cmu-argus-2/Avionics-Plus-Z/+Z.step

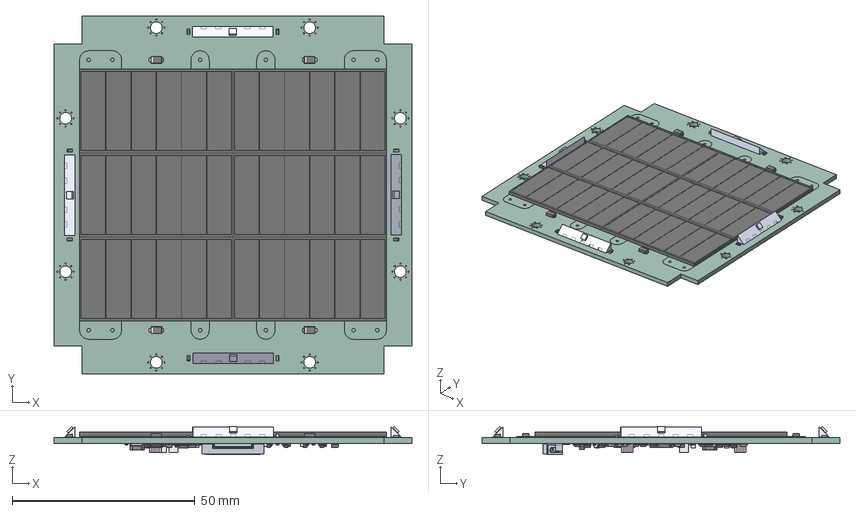
[picture p1: CAD file, 2026-02-09]
+Z.step
98.0 x 98.0 x 7.70 mm
D_PowerDI-123 x 6
R_0603_1608Metric x 117
SS_Base x 4
BODY-SON.stp x 4
FRAME-DNP0006A.stp x 4
DIE.stp x 4
BOND_WIRE_AF0.stp x 4
BOND_WIRE_AF1.stp x 4
BOND_WIRE_AF2.stp x 4
BOND_WIRE_AF3.stp x 4
BOND_WIRE_AF4.stp x 4
BOND_WIRE_AF5.stp x 4
C_0603_1608Metric x 26
SM141K06TF x 6
Cell Backer_PCB
SOT-363_SC-70-6 x 24
C_1210_3225Metric x 4
Fuse_0603_1608Metric x 10
SOT-23-6
QFN-20-1EP_3x4mm_P0.5mm_EP1.65x2.65mm
D_SOD-123F
+Z 1.74.1
BODY-QFN
PIN1-ID
TSOT-23-6
C_0805_2012Metric x 3
Pins
SOT-23
LPS4018-103MRC
LED_0603_1608Metric
SIRA99DP-T1-GE3 x 2
MSOP-10_3x3mm_P0.5mm
R_2512_6332Metric
+Z_PCB
