cmu-argus-2/Avionics-Plus-Z/Cell Backer/Cell Backer.step

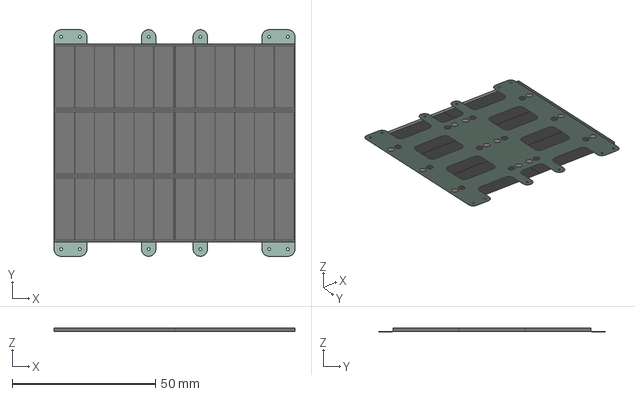
[picture p2: CAD file, 2026-02-09]
Cell Backer/Cell Backer.step
84.0 x 79.0 x 1.30 mm
SM141K06TF x 6
Cell Backer_PCB
