cmu-argus-2/Avionics-Plus-Z/LightSensorBreakout/LightSensorBreakout.step

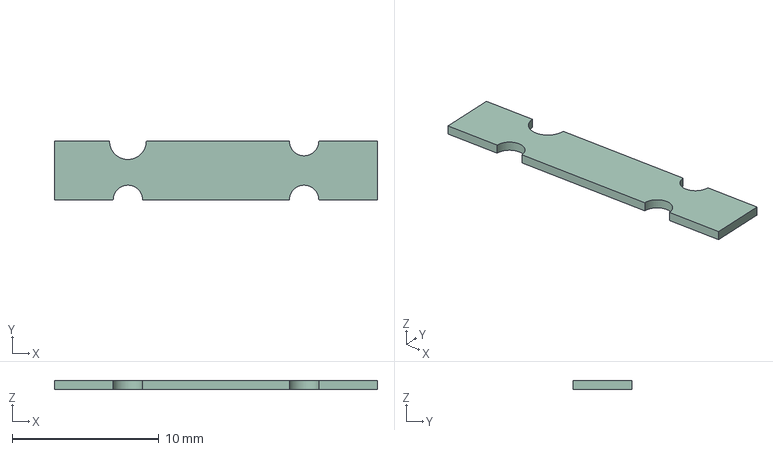
[picture p3: CAD file, 2026-01-21]
LightSensorBreakout/LightSensorBreakout.step
22.0 x 4.00 x 0.6 mm
