cmu-argus-2/Avionics-Plus-Z/+Z.kicad_pcb

## KiCad design +Z.kicad_pcb (2026-03-23)

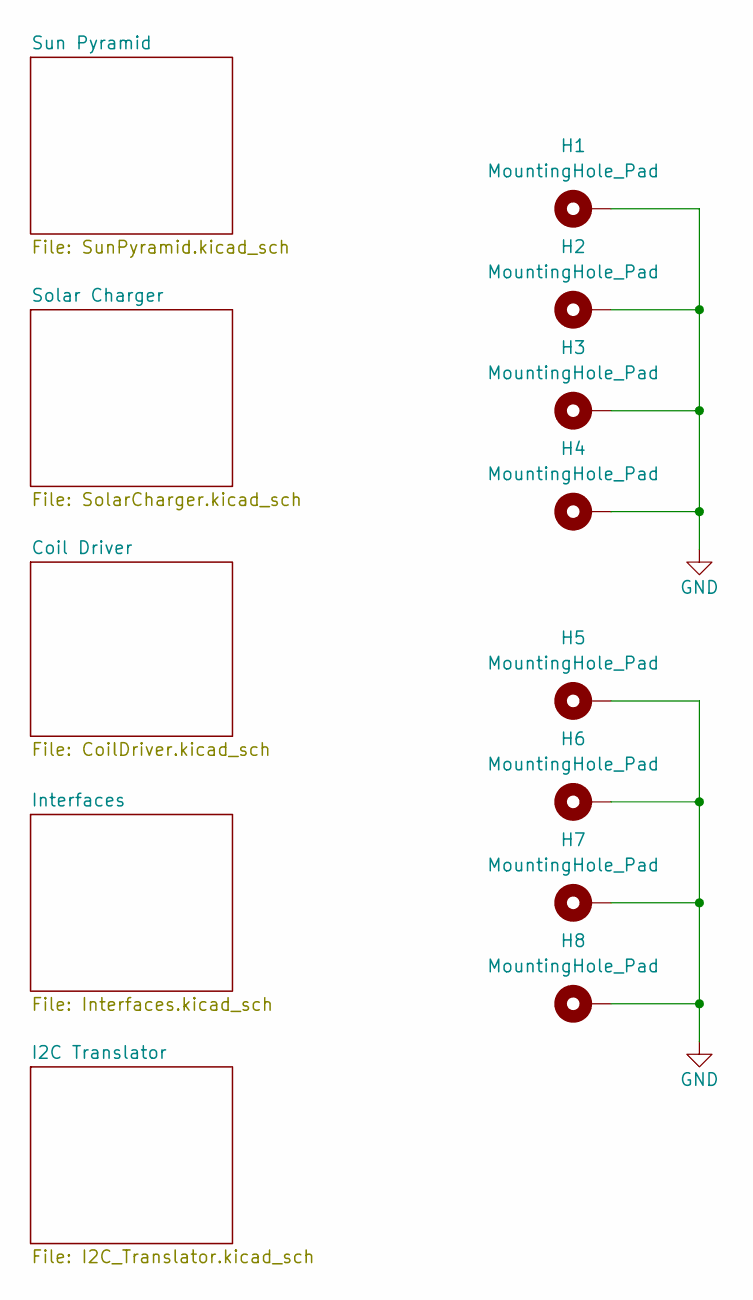
[picture p4: schematic +Z.kicad_sch, Argus +Z Solar Panel]

Parts:
H1, H2, H3, H4, H5, H6, H7, H8: MountingHole_Pad; MountingHole_3.2mm_M3_DIN965_Pad_TopBottom

Connections:
GND: H1.1, H2.1, H3.1, H4.1, H5.1, H6.1, H7.1, H8.1; also elsewhere on the board

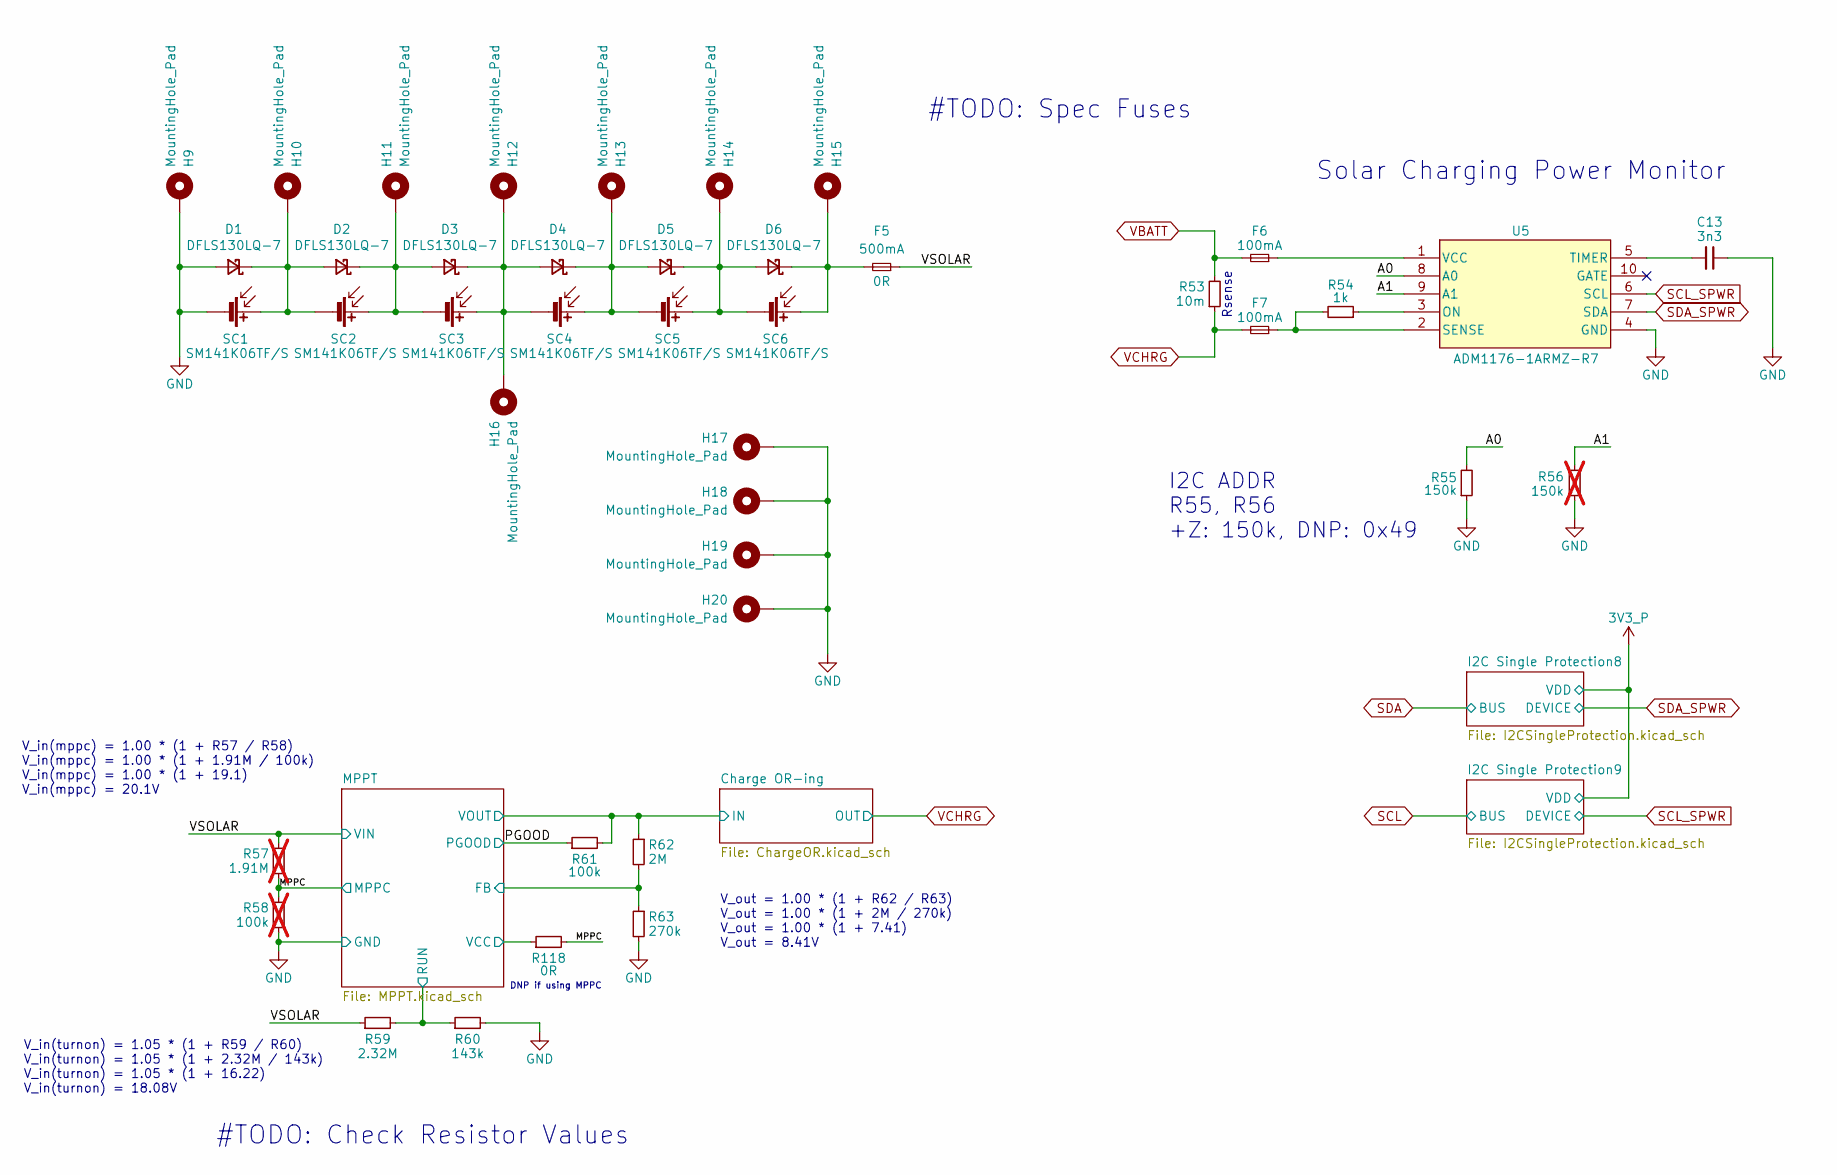
[picture p5: schematic SolarCharger.kicad_sch, Argus +Z Solar Panel]

Parts:
C13: 3n3; C_0603_1608Metric; MPN C3877267
D1, D2, D3, D4, D5, D6: DFLS130LQ-7; D_PowerDI-123
F5: 500mA; Fuse_0603_1608Metric
F6, F7: 100mA; Fuse_0603_1608Metric
H9, H10, H11, H12, H13, H14, H15, H16, H17, H18, H19, H20: MountingHole_Pad; TestPoint_Pad_D1.0mm
R53: 10m; R_2512_6332Metric; MPN C840621
R54: 1k; R_0603_1608Metric; MPN C2484712
R55: 150k; R_0603_1608Metric
R56: 150k; R_0603_1608Metric; MPN C402995; not fitted
R57: 1.91M; R_0603_1608Metric; not fitted
R58: 100k; R_0603_1608Metric; not fitted
R59: 2.32M; R_0603_1608Metric
R60: 143k; R_0603_1608Metric
R61: 100k; R_0603_1608Metric; MPN C237792
R62: 2M; R_0603_1608Metric
R63: 270k; R_0603_1608Metric; MPN C118142
R118: 0R; R_0603_1608Metric; MPN C237792
SC1, SC2, SC3, SC4, SC5, SC6: SM141K06TF/S; SM141K06TF_S
U5: ADM1176-1ARMZ-R7; MSOP-10_3x3mm_P0.5mm; Manufacturer_Part_Number ADM1176-1ARMZ-R7

Connections:
/Solar Charger/A0: R55.2, U5.8 (A0)
/Solar Charger/A1: R56.2, U5.9 (A1)
/Solar Charger/Charge OR-ing/IN: R61.2, R62.1; also elsewhere on the board
/Solar Charger/MPPC: R57.2, R58.1, R118.2; also elsewhere on the board
/Solar Charger/MPPT/FB: R62.2, R63.1; also elsewhere on the board
/Solar Charger/MPPT/RUN: R59.2, R60.1; also elsewhere on the board
/Solar Charger/MPPT/VCC: R118.1; also elsewhere on the board
/Solar Charger/PGOOD: R61.1; also elsewhere on the board
/Solar Charger/VSOLAR: F5.1, R57.1, R59.1; also elsewhere on the board
GND: C13.1, D1.2 (A), H9.1, H17.1, H18.1, H19.1, H20.1, R55.1, R56.1, R58.2, R60.2, R63.2, SC1.2 (-), U5.4 (GND); also elsewhere on the board
unnamed: D1.1 (K), D2.2 (A), H10.1, SC1.1 (+), SC2.2 (-)
unnamed: D2.1 (K), D3.2 (A), H11.1, SC2.1 (+), SC3.2 (-)
unnamed: D3.1 (K), D4.2 (A), H12.1, H16.1, SC3.1 (+), SC4.2 (-)
unnamed: D4.1 (K), D5.2 (A), H13.1, SC4.1 (+), SC5.2 (-)
unnamed: D5.1 (K), D6.2 (A), H14.1, SC5.1 (+), SC6.2 (-)
unnamed: D6.1 (K), F5.2, H15.1, SC6.1 (+)
unnamed: R54.1, U5.3 (ON)
unnamed: F7.1, R54.2, U5.2 (SENSE)
unnamed: C13.2, U5.5 (TIMER)
unnamed: F6.1, U5.1 (VCC)
SCL_SPWR: U5.6 (SCL); also elsewhere on the board
SDA_SPWR: U5.7 (SDA); also elsewhere on the board
VBATT: F6.2, R53.2; also elsewhere on the board
VCHRG: F7.2, R53.1; also elsewhere on the board

Notes on the sheet:
V_in(mppc) = 1.00 * (1 + R57 / R58) V_in(mppc) = 1.00 * (1 + 1.91M / 100k) V_in(mppc) = 1.00 * (1 + 19.1) V_in(mppc) = 20.1V
#TODO: Spec Fuses
V_in(turnon) = 1.05 * (1 + R59 / R60) V_in(turnon) = 1.05 * (1 + 2.32M / 143k) V_in(turnon) = 1.05 * (1 + 16.22) V_in(turnon) = 18.08V
Rsense
V_out = 1.00 * (1 + R62 / R63) V_out = 1.00 * (1 + 2M / 270k) V_out = 1.00 * (1 + 7.41) V_out = 8.41V
#TODO: Check Resistor Values
DNP if using MPPC
I2C ADDR R55, R56 +Z: 150k, DNP: 0x49
Solar Charging Power Monitor

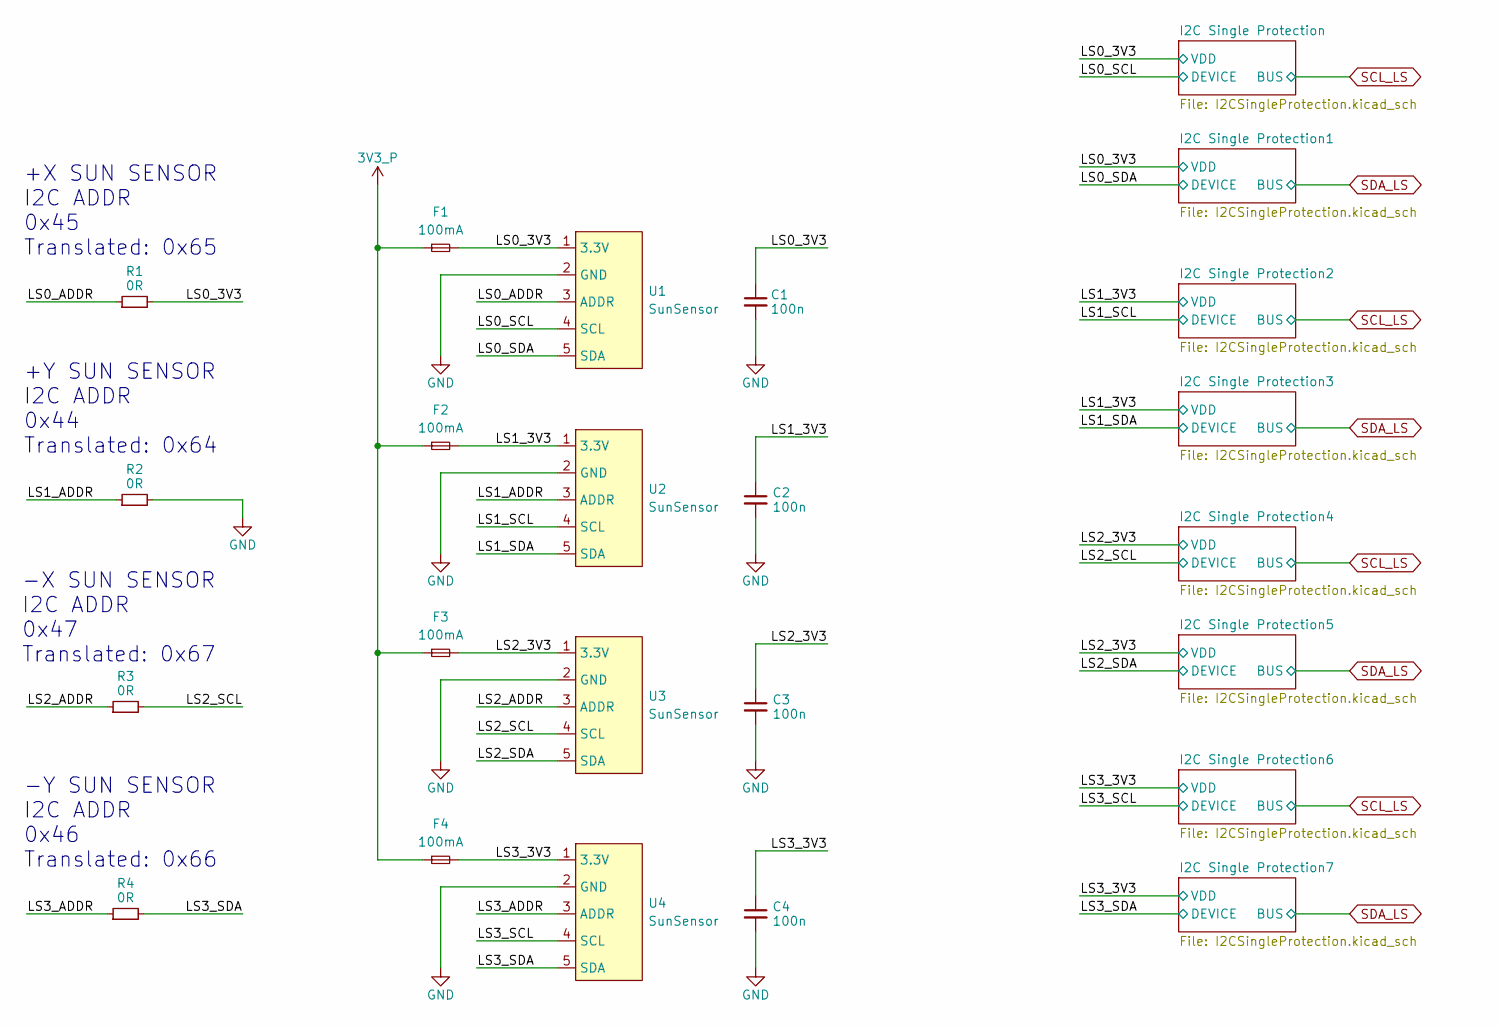
[picture p6: schematic SunPyramid.kicad_sch, Argus +Z Solar Panel]

Parts:
C1, C2, C3, C4: 100n; C_0603_1608Metric; MPN C307348
F1, F2, F3, F4: 100mA; Fuse_0603_1608Metric
R1, R2, R3, R4: 0R; R_0603_1608Metric; MPN C844915
U1, U2, U3, U4: SunSensor

Connections:
3V3_P: F1.1, F2.1, F3.1, F4.1; also elsewhere on the board
/Sun Pyramid/LS0_3V3: C1.1, F1.2, R1.2, U1.1 (3.3V); also elsewhere on the board
/Sun Pyramid/LS0_ADDR: R1.1, U1.3 (ADDR)
/Sun Pyramid/LS0_SCL: U1.4 (SCL); also elsewhere on the board
/Sun Pyramid/LS0_SDA: U1.5 (SDA); also elsewhere on the board
/Sun Pyramid/LS1_3V3: C2.1, F2.2, U2.1 (3.3V); also elsewhere on the board
/Sun Pyramid/LS1_ADDR: R2.1, U2.3 (ADDR)
/Sun Pyramid/LS1_SCL: U2.4 (SCL); also elsewhere on the board
/Sun Pyramid/LS1_SDA: U2.5 (SDA); also elsewhere on the board
/Sun Pyramid/LS2_3V3: C3.1, F3.2, U3.1 (3.3V); also elsewhere on the board
/Sun Pyramid/LS2_ADDR: R3.1, U3.3 (ADDR)
/Sun Pyramid/LS2_SCL: R3.2, U3.4 (SCL); also elsewhere on the board
/Sun Pyramid/LS2_SDA: U3.5 (SDA); also elsewhere on the board
/Sun Pyramid/LS3_3V3: C4.1, F4.2, U4.1 (3.3V); also elsewhere on the board
/Sun Pyramid/LS3_ADDR: R4.1, U4.3 (ADDR)
/Sun Pyramid/LS3_SCL: U4.4 (SCL); also elsewhere on the board
/Sun Pyramid/LS3_SDA: R4.2, U4.5 (SDA); also elsewhere on the board
GND: C1.2, C2.2, C3.2, C4.2, R2.2, U1.2 (GND), U2.2 (GND), U3.2 (GND), U4.2 (GND); also elsewhere on the board

Notes on the sheet:
-Y SUN SENSOR I2C ADDR 0x46 Translated: 0x66
-X SUN SENSOR I2C ADDR 0x47 Translated: 0x67
+X SUN SENSOR I2C ADDR 0x45 Translated: 0x65
+Y SUN SENSOR I2C ADDR 0x44 Translated: 0x64

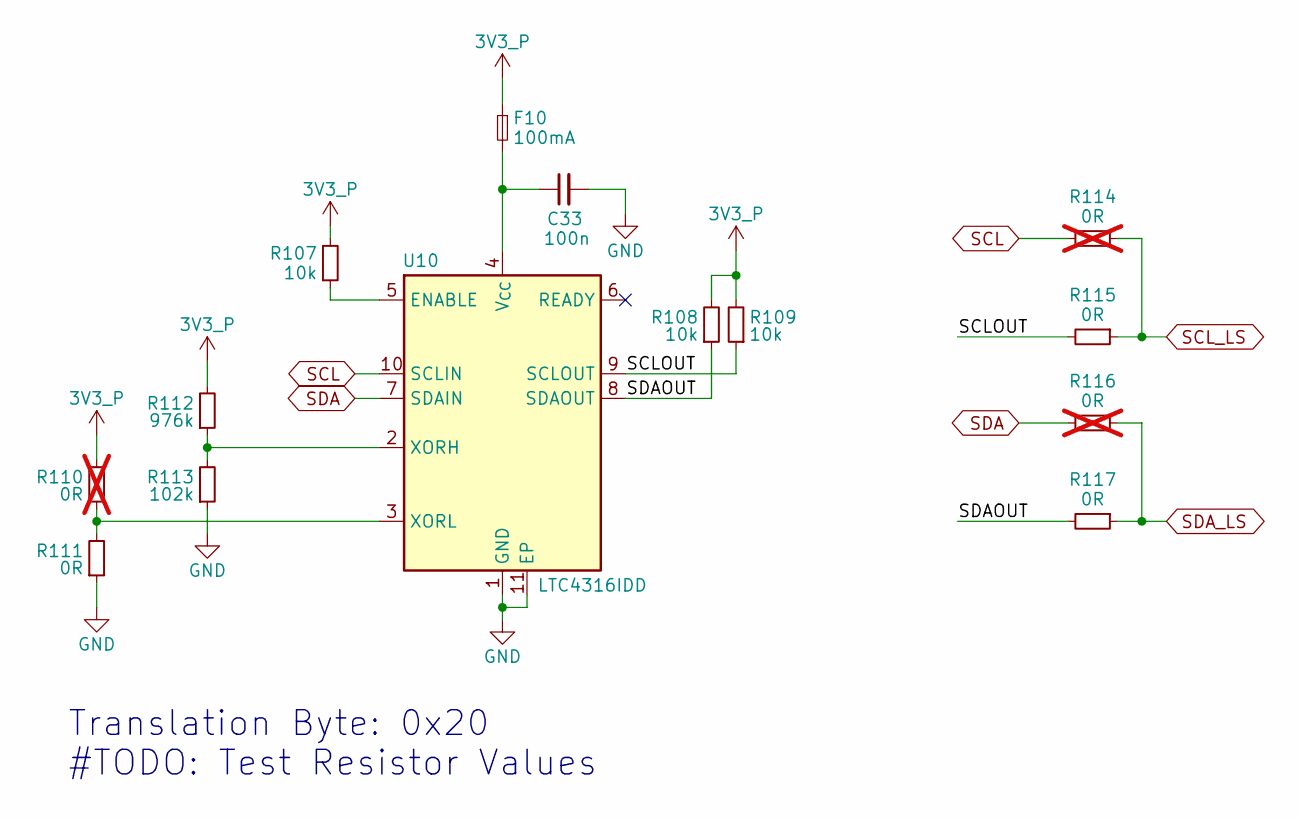
[picture p7: schematic I2C_Translator.kicad_sch, Argus +Z Solar Panel]

Parts:
C33: 100n; C_0603_1608Metric; MPN C307348
F10: 100mA; Fuse_0603_1608Metric
R107, R108, R109: 10k; R_0603_1608Metric; MPN C2479067
R110, R114, R116: 0R; R_0603_1608Metric; not fitted
R111, R115, R117: 0R; R_0603_1608Metric; MPN C844915
R112: 976k; R_0603_1608Metric
R113: 102k; R_0603_1608Metric
U10: LTC4316IDD; DFN-10-1EP_3x3mm_P0.5mm_EP1.65x2.38mm; MPN C688147

Connections:
3V3_P: F10.1, R107.2, R108.2, R109.2, R110.2, R112.2; also elsewhere on the board
/I2C Translator/SCLOUT: R109.1, R115.2, U10.9 (SCLOUT)
/I2C Translator/SDAOUT: R108.1, R117.2, U10.8 (SDAOUT)
GND: C33.2, R111.1, R113.1, U10.1 (GND), U10.11 (EP); also elsewhere on the board
unnamed: R107.1, U10.5 (ENABLE)
unnamed: C33.1, F10.2, U10.4 (V_{CC})
unnamed: R112.1, R113.2, U10.2 (XORH)
unnamed: R110.1, R111.2, U10.3 (XORL)
SCL: R114.2, U10.10 (SCLIN); also elsewhere on the board
SCL_LS: R114.1, R115.1; also elsewhere on the board
SDA: R116.2, U10.7 (SDAIN); also elsewhere on the board
SDA_LS: R116.1, R117.1; also elsewhere on the board

Notes on the sheet:
Translation Byte: 0x20 #TODO: Test Resistor Values

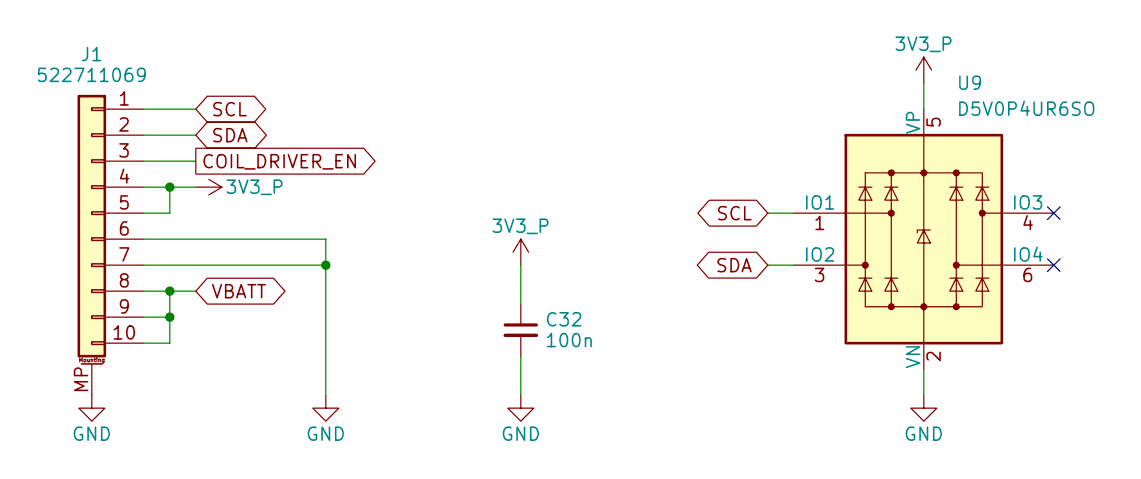
[picture p8: schematic Interfaces.kicad_sch, Argus +Z Solar Panel]

Parts:
C32: 100n; C_0603_1608Metric; MPN C307348
J1: 522711069; CON_522711069_MOL; MPN C588180
U9: D5V0P4UR6SO; SOT-23-6; MPN C531179

Connections:
3V3_P: C32.1, J1.4, J1.5, U9.5 (VP); also elsewhere on the board
COIL_DRIVER_EN: J1.3; also elsewhere on the board
GND: C32.2, J1.6, J1.7, J1.MP (MountPin), U9.2 (VN); also elsewhere on the board
SCL: J1.1, U9.1 (IO1); also elsewhere on the board
SDA: J1.2, U9.3 (IO2); also elsewhere on the board
VBATT: J1.8, J1.9, J1.10; also elsewhere on the board

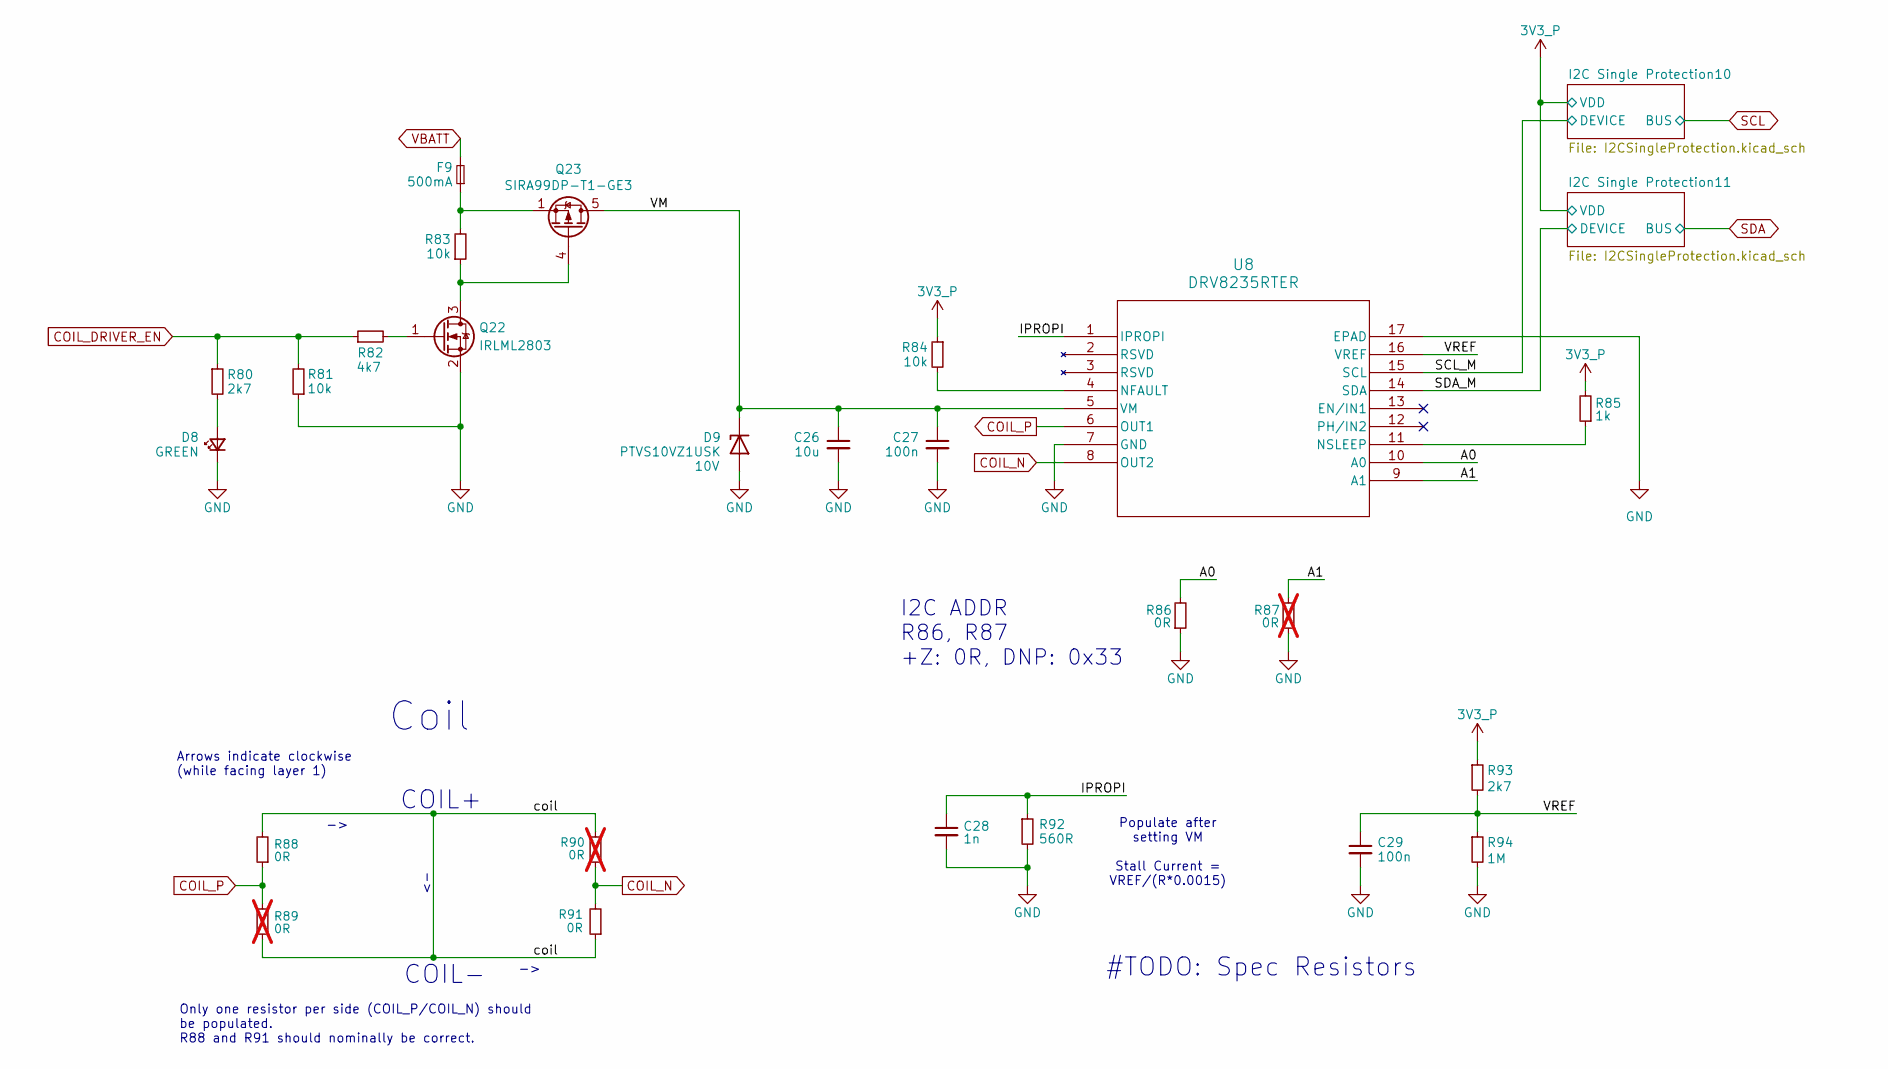
[picture p9: schematic CoilDriver.kicad_sch, Argus +Z Solar Panel]

Parts:
C26: 10u; C_1210_3225Metric; MPN C126617
C27, C29: 100n; C_0603_1608Metric; MPN C307348
C28: 1n; C_0603_1608Metric; MPN C161231
D8: GREEN; LED_0603_1608Metric; MPN C2909774
D9: PTVS10VZ1USK; Nexperia_DSN1608-2_1.6x0.8mm
F9: 500mA; Fuse_0603_1608Metric
Q22: IRLML2803; SOT-23; MPN C2590
Q23: SIRA99DP-T1-GE3; PowerPAK_SO-8_Single; MPN C3289459
R80: 2k7; R_0603_1608Metric; MPN C237112
R81, R83, R84: 10k; R_0603_1608Metric; MPN C2479067
R82: 4k7; R_0603_1608Metric; MPN C844931
R85: 1k; R_0603_1608Metric; MPN C2484712
R86, R88, R91: 0R; R_0603_1608Metric; MPN C844915
R87: 0R; R_0603_1608Metric; MPN C844915; not fitted
R89, R90: 0R; R_0603_1608Metric; not fitted
R92: 560R; R_0603_1608Metric
R93: 2k7; R_0603_1608Metric
R94: 1M; R_0603_1608Metric
U8: DRV8235RTER; WQFN16_RTE_TEX

Connections:
3V3_P: R84.1, R85.2, R93.1; also elsewhere on the board
/Coil Driver/A0: R86.2, U8.10 (A0)
/Coil Driver/A1: R87.2, U8.9 (A1)
/Coil Driver/IPROPI: C28.1, R92.1, U8.1 (IPROPI)
/Coil Driver/SCL_M: U8.15 (SCL); also elsewhere on the board
/Coil Driver/SDA_M: U8.14 (SDA); also elsewhere on the board
/Coil Driver/VM: C26.1, C27.1, D9.1 (K), Q23.5 (D), U8.5 (VM)
/Coil Driver/VREF: C29.1, R93.2, R94.1, U8.16 (VREF)
/Coil Driver/coil: R88.2, R89.1, R90.2, R91.1
COIL_DRIVER_EN: R80.1, R81.2, R82.1; also elsewhere on the board
COIL_N: R90.1, R91.2, U8.8 (OUT2)
COIL_P: R88.1, R89.2, U8.6 (OUT1)
GND: C26.2, C27.2, C28.2, C29.2, D8.1 (K), D9.2 (A), Q22.2 (S), R81.1, R86.1, R87.1, R92.2, R94.2, U8.7 (GND), U8.17 (EPAD); also elsewhere on the board
unnamed: D8.2 (A), R80.2
unnamed: F9.1, Q23.1 (S), Q23.2 (S), Q23.3 (S), R83.2
unnamed: Q22.3 (D), Q23.4 (G), R83.1
unnamed: Q22.1 (G), R82.2
unnamed: R84.2, U8.4 (NFAULT)
unnamed: R85.1, U8.11 (NSLEEP)
VBATT: F9.2; also elsewhere on the board

Notes on the sheet:
#TODO: Spec Resistors
I2C ADDR R86, R87 +Z: 0R, DNP: 0x33
COIL+
Coil
Arrows indicate clockwise (while facing layer 1)
Only one resistor per side (COIL_P/COIL_N) should be populated. R88 and R91 should nominally be correct.
COIL-
Populate after setting VM Stall Current = VREF/(R*0.0015)

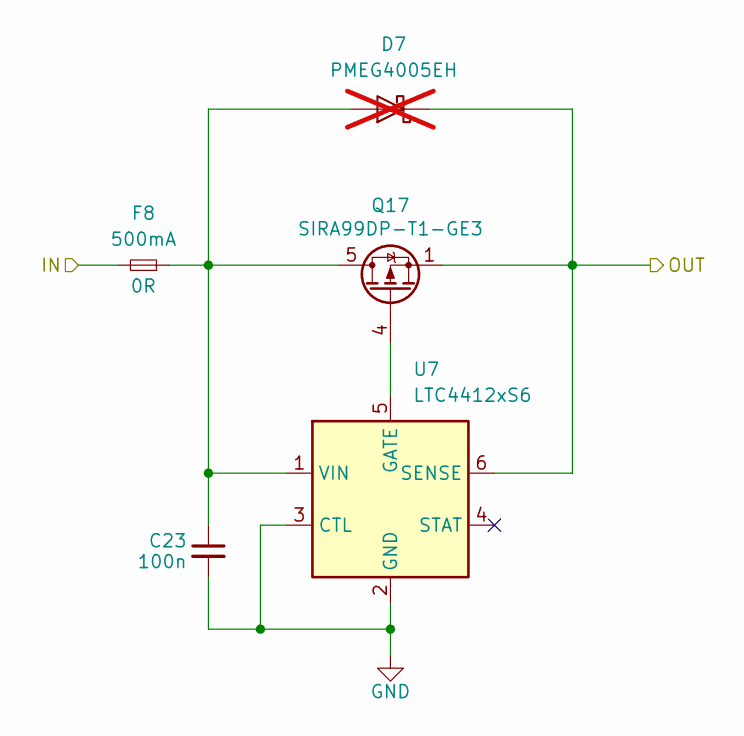
[picture p10: schematic ChargeOR.kicad_sch, Argus +Z Solar Panel]

Parts:
C23: 100n; C_0603_1608Metric; MPN C307348
D7: PMEG4005EH; D_SOD-123F; not fitted
F8: 500mA; Fuse_0603_1608Metric
Q17: SIRA99DP-T1-GE3; PowerPAK_SO-8_Single; MPN C3289459
U7: LTC4412xS6; TSOT-23-6

Connections:
/Solar Charger/Charge OR-ing/IN: F8.2; also elsewhere on the board
GND: C23.2, U7.2 (GND), U7.3 (CTL); also elsewhere on the board
unnamed: C23.1, D7.2 (A), F8.1, Q17.5 (D), U7.1 (VIN)
unnamed: Q17.4 (G), U7.5 (GATE)
VCHRG: D7.1 (K), Q17.1 (S), Q17.2 (S), Q17.3 (S), U7.6 (SENSE); also elsewhere on the board

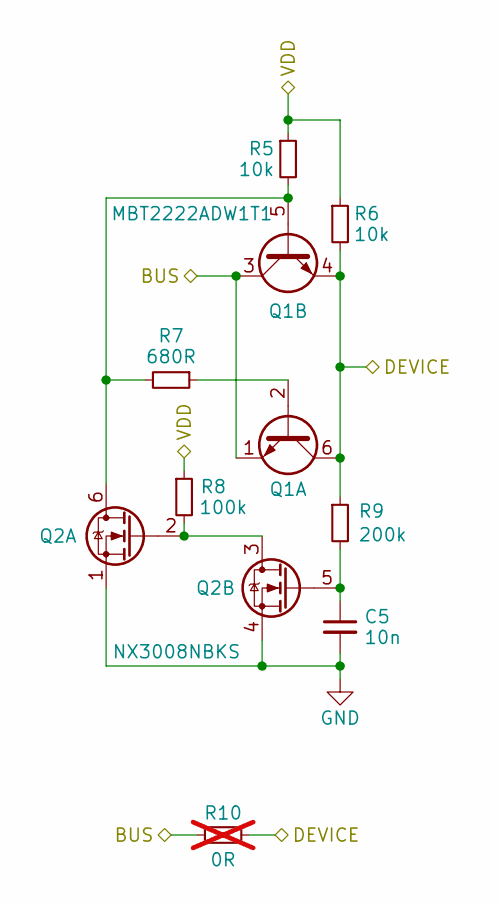
[picture p11: schematic I2CSingleProtection.kicad_sch, Argus +Z Solar Panel]

Parts:
C5: 10n; C_0603_1608Metric; MPN C161232
Q1: MBT2222ADW1T1; SOT-363_SC-70-6; Manufacturer_Part_Number MBT2222ADW1T1G
Q2: NX3008NBKS; SOT-363_SC-70-6; MPN C3280240
R5, R6: 10k; R_0603_1608Metric; MPN C2479067
R7: 680R; R_0603_1608Metric; MPN C844802
R8: 100k; R_0603_1608Metric; MPN C237792
R9: 200k; R_0603_1608Metric; MPN C118142
R10: 0R; R_0603_1608Metric; not fitted

Connections:
/Sun Pyramid/LS0_3V3: R5.1, R6.1, R8.1; also elsewhere on the board
/Sun Pyramid/LS0_SCL: Q1.4 (E2), Q1.6 (C1), R6.2, R9.1, R10.1; also elsewhere on the board
GND: C5.2, Q2.1 (S2), Q2.4 (S1); also elsewhere on the board
unnamed: Q1.2 (B1), R7.1
unnamed: Q1.5 (B2), Q2.6 (D1), R5.2, R7.2
unnamed: Q2.2 (G2), Q2.3 (D2), R8.2
unnamed: C5.1, Q2.5 (G1), R9.2
SCL_LS: Q1.1 (E1), Q1.3 (C2), R10.2; also elsewhere on the board

Parts of its further copies:
C6, C7, C8, C9, C10, C11, C12, C24, C25, C30, C31: 10n; C_0603_1608Metric; MPN C161232
Q3, Q5, Q7, Q9, Q11, Q13, Q15, Q18, Q20, Q24, Q26: MBT2222ADW1T1; SOT-363_SC-70-6; Manufacturer_Part_Number MBT2222ADW1T1G
Q4, Q6, Q8, Q10, Q12, Q14, Q16, Q19, Q21, Q25, Q27: NX3008NBKS; SOT-363_SC-70-6; MPN C3280240
R11, R12, R17, R18, R23, R24, R29, R30, R35, R36, R41, R42, R47, R48, R68, R69, R74, R75, R95, R96, R101, R102: 10k; R_0603_1608Metric; MPN C2479067
R13, R19, R25, R31, R37, R43, R49, R70, R76, R97, R103: 680R; R_0603_1608Metric; MPN C844802
R14, R20, R26, R32, R38, R44, R50, R71, R77, R98, R104: 100k; R_0603_1608Metric; MPN C237792
R15, R21, R27, R33, R39, R45, R51, R72, R78, R99, R105: 200k; R_0603_1608Metric; MPN C118142
R16, R22, R28, R34, R40, R46, R52, R73, R79, R100, R106: 0R; R_0603_1608Metric; not fitted

Connections of its further copies:
3V3_P: R68.1, R69.1, R71.1, R74.1, R75.1, R77.1, R95.1, R96.1, R98.1, R101.1, R102.1, R104.1; also elsewhere on the board
/Coil Driver/SCL_M: Q24.4 (E2), Q24.6 (C1), R96.2, R99.1, R100.1; also elsewhere on the board
/Coil Driver/SDA_M: Q26.4 (E2), Q26.6 (C1), R102.2, R105.1, R106.1; also elsewhere on the board
/Sun Pyramid/LS0_3V3: R11.1, R12.1, R14.1; also elsewhere on the board
/Sun Pyramid/LS0_SDA: Q3.4 (E2), Q3.6 (C1), R12.2, R15.1, R16.1; also elsewhere on the board
/Sun Pyramid/LS1_3V3: R17.1, R18.1, R20.1, R23.1, R24.1, R26.1; also elsewhere on the board
/Sun Pyramid/LS1_SCL: Q5.4 (E2), Q5.6 (C1), R18.2, R21.1, R22.1; also elsewhere on the board
/Sun Pyramid/LS1_SDA: Q7.4 (E2), Q7.6 (C1), R24.2, R27.1, R28.1; also elsewhere on the board
/Sun Pyramid/LS2_3V3: R29.1, R30.1, R32.1, R35.1, R36.1, R38.1; also elsewhere on the board
/Sun Pyramid/LS2_SCL: Q9.4 (E2), Q9.6 (C1), R30.2, R33.1, R34.1; also elsewhere on the board
/Sun Pyramid/LS2_SDA: Q11.4 (E2), Q11.6 (C1), R36.2, R39.1, R40.1; also elsewhere on the board
/Sun Pyramid/LS3_3V3: R41.1, R42.1, R44.1, R47.1, R48.1, R50.1; also elsewhere on the board
/Sun Pyramid/LS3_SCL: Q13.4 (E2), Q13.6 (C1), R42.2, R45.1, R46.1; also elsewhere on the board
/Sun Pyramid/LS3_SDA: Q15.4 (E2), Q15.6 (C1), R48.2, R51.1, R52.1; also elsewhere on the board
GND: C6.2, C7.2, C8.2, C9.2, C10.2, C11.2, C12.2, C24.2, C25.2, C30.2, C31.2, Q4.1 (S2), Q4.4 (S1), Q6.1 (S2), Q6.4 (S1), Q8.1 (S2), Q8.4 (S1), Q10.1 (S2), Q10.4 (S1), Q12.1 (S2), Q12.4 (S1), Q14.1 (S2), Q14.4 (S1), Q16.1 (S2), Q16.4 (S1), Q19.1 (S2), Q19.4 (S1), Q21.1 (S2), Q21.4 (S1), Q25.1 (S2), Q25.4 (S1), Q27.1 (S2), Q27.4 (S1); also elsewhere on the board
unnamed: Q3.2 (B1), R13.1
unnamed: Q3.5 (B2), Q4.6 (D1), R11.2, R13.2
unnamed: Q4.2 (G2), Q4.3 (D2), R14.2
unnamed: C6.1, Q4.5 (G1), R15.2
unnamed: Q5.2 (B1), R19.1
unnamed: Q5.5 (B2), Q6.6 (D1), R17.2, R19.2
unnamed: Q6.2 (G2), Q6.3 (D2), R20.2
unnamed: C7.1, Q6.5 (G1), R21.2
unnamed: Q7.2 (B1), R25.1
unnamed: Q7.5 (B2), Q8.6 (D1), R23.2, R25.2
unnamed: Q8.2 (G2), Q8.3 (D2), R26.2
unnamed: C8.1, Q8.5 (G1), R27.2
unnamed: Q9.2 (B1), R31.1
unnamed: Q9.5 (B2), Q10.6 (D1), R29.2, R31.2
unnamed: Q10.2 (G2), Q10.3 (D2), R32.2
unnamed: C9.1, Q10.5 (G1), R33.2
unnamed: Q11.2 (B1), R37.1
unnamed: Q11.5 (B2), Q12.6 (D1), R35.2, R37.2
unnamed: Q12.2 (G2), Q12.3 (D2), R38.2
unnamed: C10.1, Q12.5 (G1), R39.2
unnamed: Q13.2 (B1), R43.1
unnamed: Q13.5 (B2), Q14.6 (D1), R41.2, R43.2
unnamed: Q14.2 (G2), Q14.3 (D2), R44.2
unnamed: C11.1, Q14.5 (G1), R45.2
unnamed: Q15.2 (B1), R49.1
unnamed: Q15.5 (B2), Q16.6 (D1), R47.2, R49.2
unnamed: Q16.2 (G2), Q16.3 (D2), R50.2
unnamed: C12.1, Q16.5 (G1), R51.2
unnamed: Q18.2 (B1), R70.1
unnamed: Q18.5 (B2), Q19.6 (D1), R68.2, R70.2
unnamed: Q19.2 (G2), Q19.3 (D2), R71.2
unnamed: C24.1, Q19.5 (G1), R72.2
unnamed: Q20.2 (B1), R76.1
unnamed: Q20.5 (B2), Q21.6 (D1), R74.2, R76.2
unnamed: Q21.2 (G2), Q21.3 (D2), R77.2
unnamed: C25.1, Q21.5 (G1), R78.2
unnamed: Q24.2 (B1), R97.1
unnamed: Q24.5 (B2), Q25.6 (D1), R95.2, R97.2
unnamed: Q25.2 (G2), Q25.3 (D2), R98.2
unnamed: C30.1, Q25.5 (G1), R99.2
unnamed: Q26.2 (B1), R103.1
unnamed: Q26.5 (B2), Q27.6 (D1), R101.2, R103.2
unnamed: Q27.2 (G2), Q27.3 (D2), R104.2
unnamed: C31.1, Q27.5 (G1), R105.2
SCL: Q20.1 (E1), Q20.3 (C2), Q24.1 (E1), Q24.3 (C2), R79.2, R100.2; also elsewhere on the board
SCL_LS: Q5.1 (E1), Q5.3 (C2), Q9.1 (E1), Q9.3 (C2), Q13.1 (E1), Q13.3 (C2), R22.2, R34.2, R46.2; also elsewhere on the board
SCL_SPWR: Q20.4 (E2), Q20.6 (C1), R75.2, R78.1, R79.1; also elsewhere on the board
SDA: Q18.1 (E1), Q18.3 (C2), Q26.1 (E1), Q26.3 (C2), R73.2, R106.2; also elsewhere on the board
SDA_LS: Q3.1 (E1), Q3.3 (C2), Q7.1 (E1), Q7.3 (C2), Q11.1 (E1), Q11.3 (C2), Q15.1 (E1), Q15.3 (C2), R16.2, R28.2, R40.2, R52.2; also elsewhere on the board
SDA_SPWR: Q18.4 (E2), Q18.6 (C1), R69.2, R72.1, R73.1; also elsewhere on the board

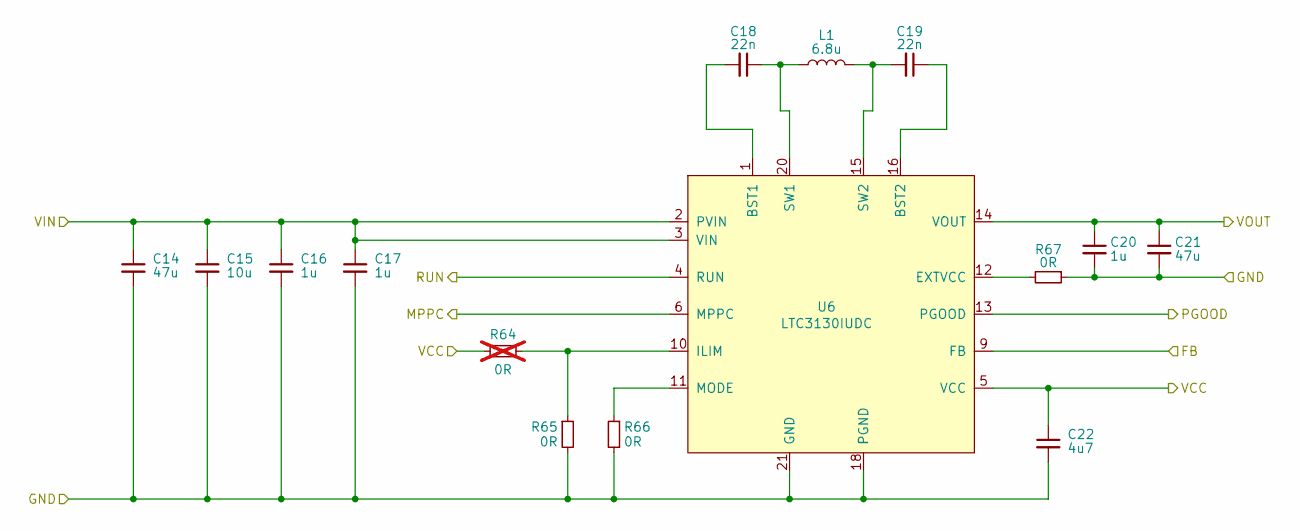
[picture p12: schematic MPPT.kicad_sch, Argus +Z Solar Panel]

Parts:
C14, C21: 47u; C_1210_3225Metric; Voltage 16V; Mfr. # GRM32EC81C476KE15L
C15: 10u; C_1210_3225Metric; MPN C126617
C16, C17, C20: 1u; C_0805_2012Metric; MPN C2214844
C18, C19: 22n; C_0603_1608Metric; MPN C161234
C22: 4u7; C_0603_1608Metric; MPN C437575
L1: 6.8u; L_Coilcraft_LPS4018; Mfr. # LPS4018-472
R64: 0R; R_0603_1608Metric; not fitted
R65, R66, R67: 0R; R_0603_1608Metric; MPN C844915
U6: LTC3130IUDC; QFN-20-1EP_3x4mm_P0.5mm_EP1.65x2.65mm; MPN C684244

Connections:
/Solar Charger/Charge OR-ing/IN: C20.1, C21.1, U6.14 (VOUT); also elsewhere on the board
/Solar Charger/MPPC: U6.6 (MPPC); also elsewhere on the board
/Solar Charger/MPPT/FB: U6.9 (FB); also elsewhere on the board
/Solar Charger/MPPT/RUN: U6.4 (RUN); also elsewhere on the board
/Solar Charger/MPPT/VCC: C22.1, R64.2, U6.5 (VCC); also elsewhere on the board
/Solar Charger/PGOOD: U6.13 (PGOOD); also elsewhere on the board
/Solar Charger/VSOLAR: C14.1, C15.1, C16.1, C17.1, U6.2 (PVIN), U6.3 (VIN); also elsewhere on the board
GND: C14.2, C15.2, C16.2, C17.2, C20.2, C21.2, C22.2, R65.2, R66.2, R67.1, U6.7 (GND), U6.8 (GND), U6.17 (GND), U6.18 (PGND), U6.19 (PGND), U6.21 (GND); also elsewhere on the board
unnamed: C18.2, U6.1 (BST1)
unnamed: C19.1, U6.16 (BST2)
unnamed: R67.2, U6.12 (EXTVCC)
unnamed: R64.1, R65.1, U6.10 (ILIM)
unnamed: R66.1, U6.11 (MODE)
unnamed: C18.1, L1.1, U6.20 (SW1)
unnamed: C19.2, L1.2, U6.15 (SW2)

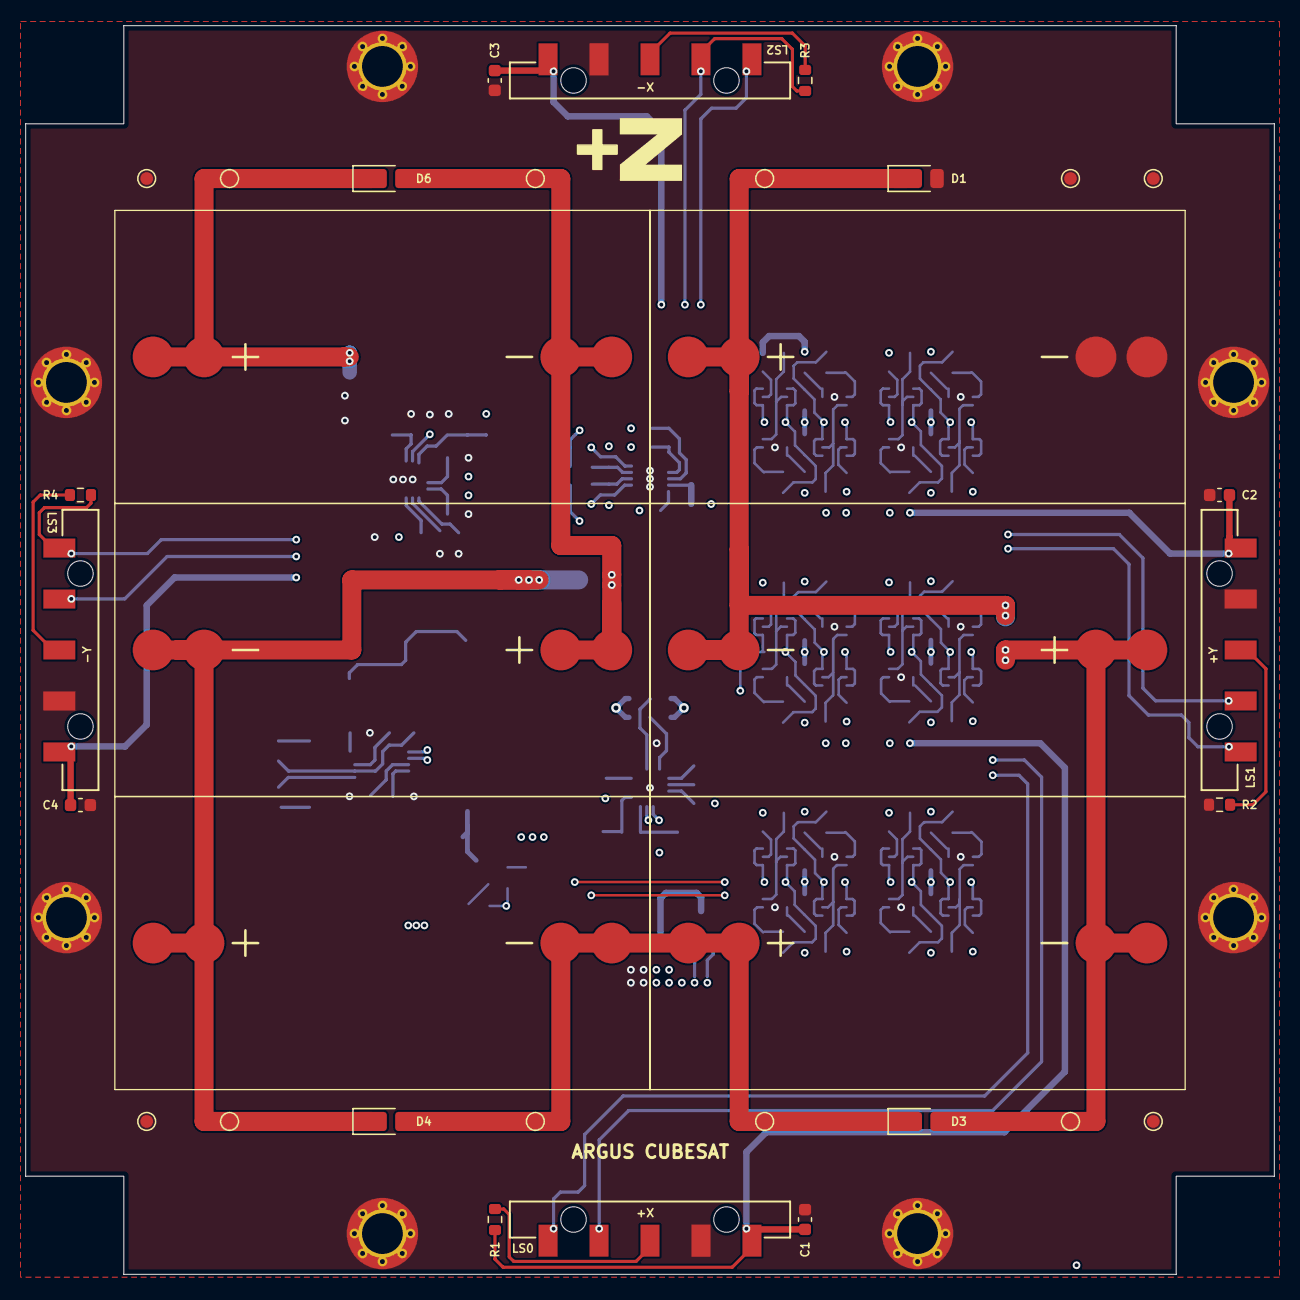
[picture p13: board +Z.kicad_pcb from above]

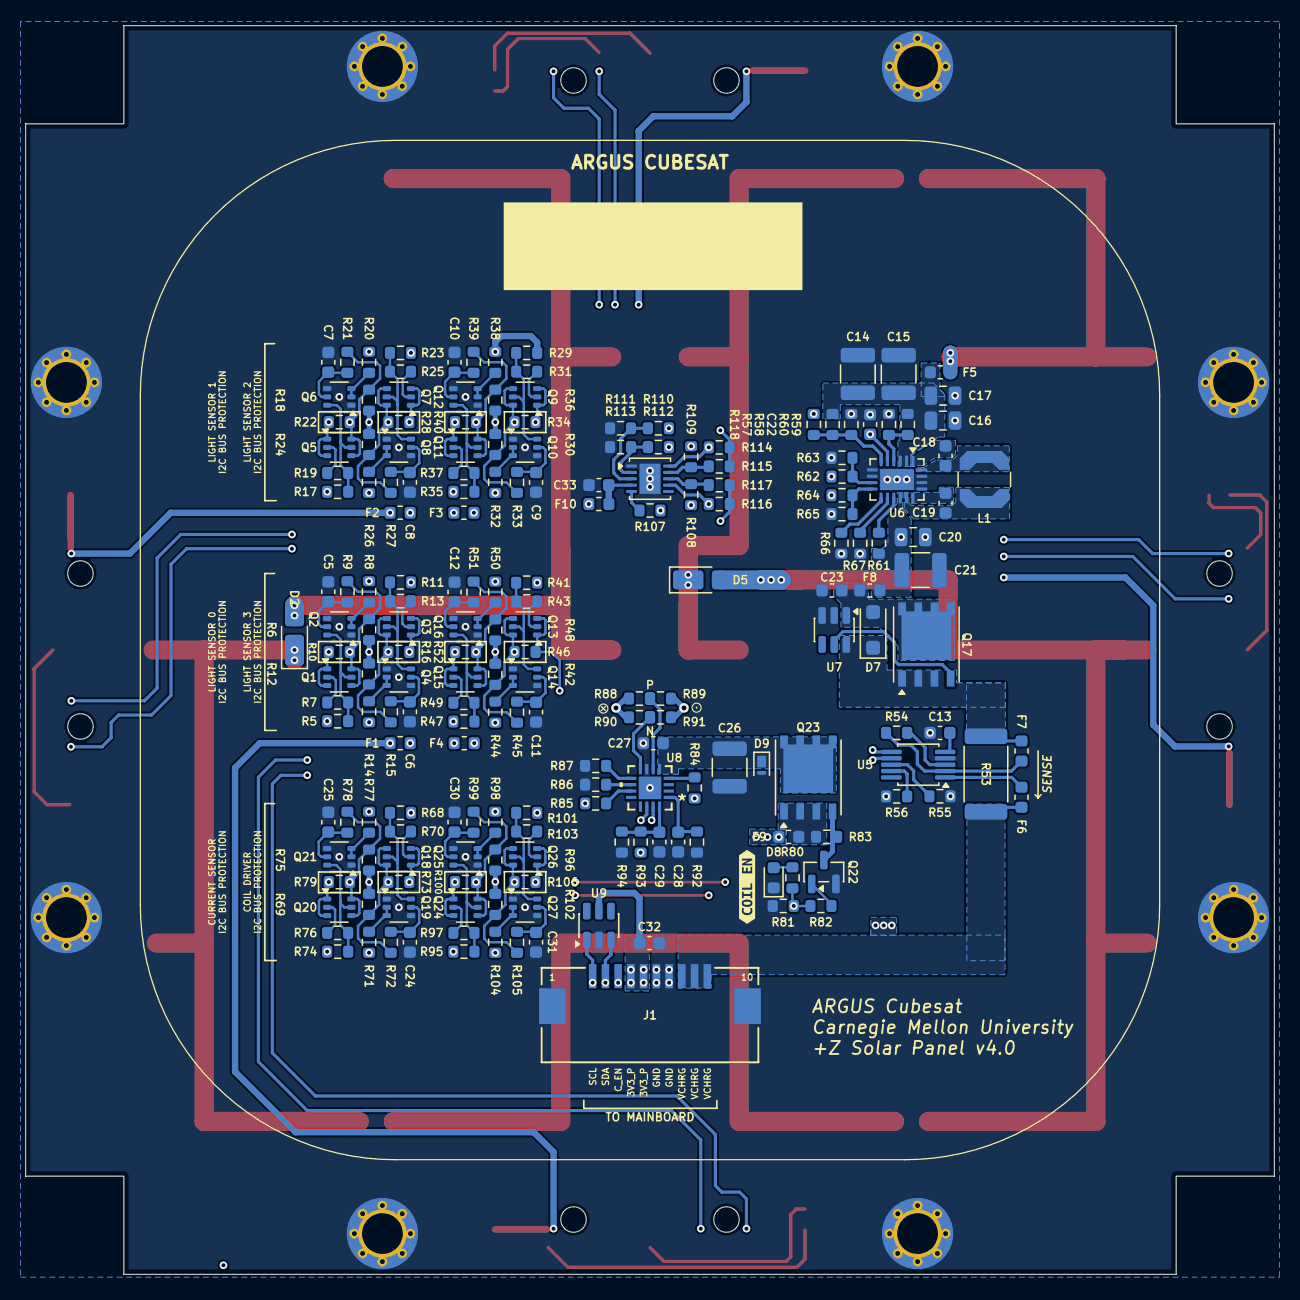
[picture p14: board +Z.kicad_pcb from below]

Board: 4 copper layers, 98.0 x 98.0 mm, 237 parts (194 on the bottom side), 125 nets.

Other parts of the board:
Ref**: Val**; ypanel
kibuzzard-680A9610: G***; kibuzzard-680A9610
