cmu-argus-2/Avionics-Plus-Z/Cell Backer/Cell Backer.kicad_pcb

## KiCad design Cell Backer/Cell Backer.kicad_pcb (2026-02-09)

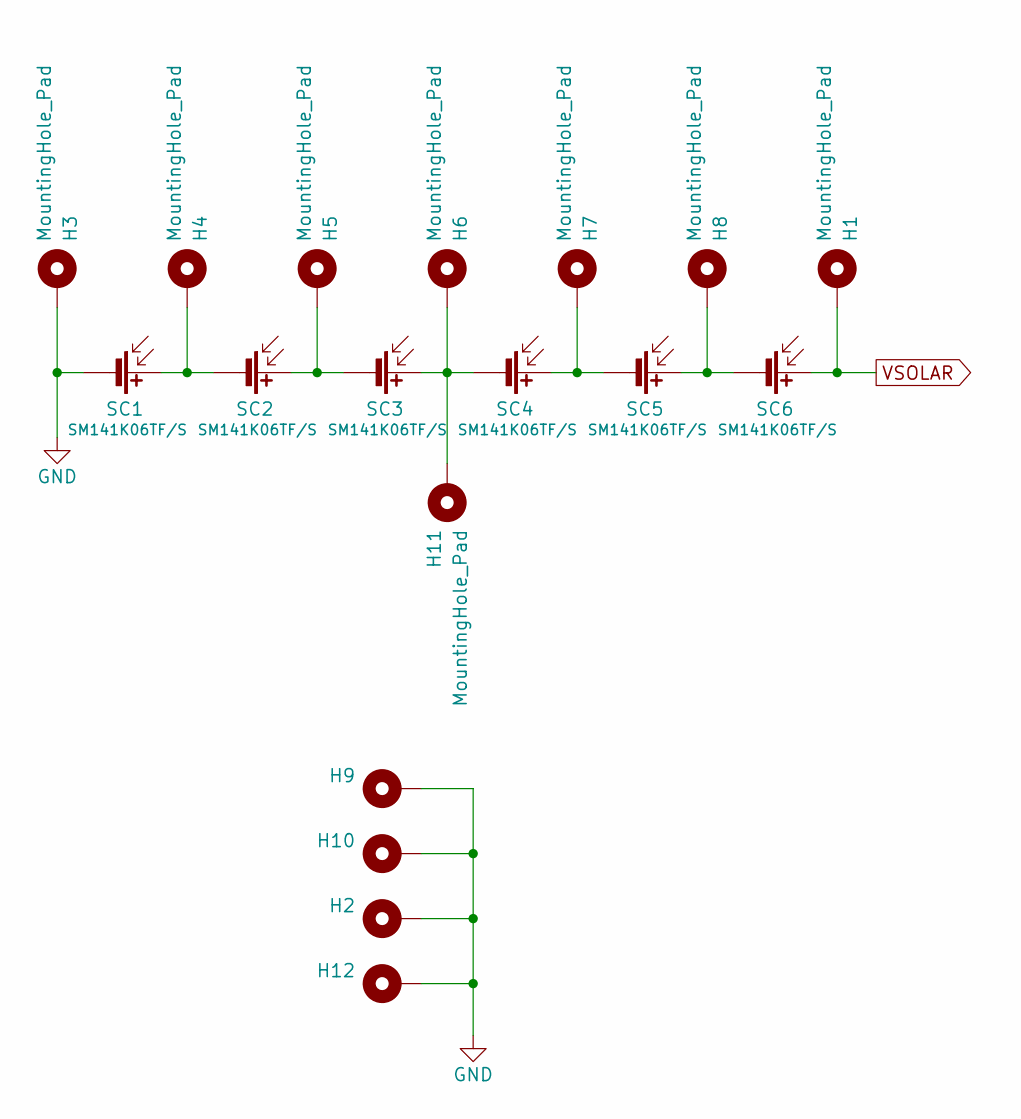
[picture p15: schematic Cell Backer.kicad_sch]

Parts:
H1, H2, H3, H4, H5, H6, H7, H8, H9, H10, H11, H12: MountingHole_Pad; MountingHole_1mm
SC1, SC2, SC3, SC4, SC5, SC6: SM141K06TF/S; SM141K06TF_S

Connections:
GND: H2.1, H3.1, H9.1, H10.1, H12.1, SC1.2 (-)
unnamed: H4.1, SC1.1 (+), SC2.2 (-)
unnamed: H5.1, SC2.1 (+), SC3.2 (-)
unnamed: H6.1, H11.1, SC3.1 (+), SC4.2 (-)
unnamed: H7.1, SC4.1 (+), SC5.2 (-)
unnamed: H8.1, SC5.1 (+), SC6.2 (-)
VSOLAR: H1.1, SC6.1 (+)

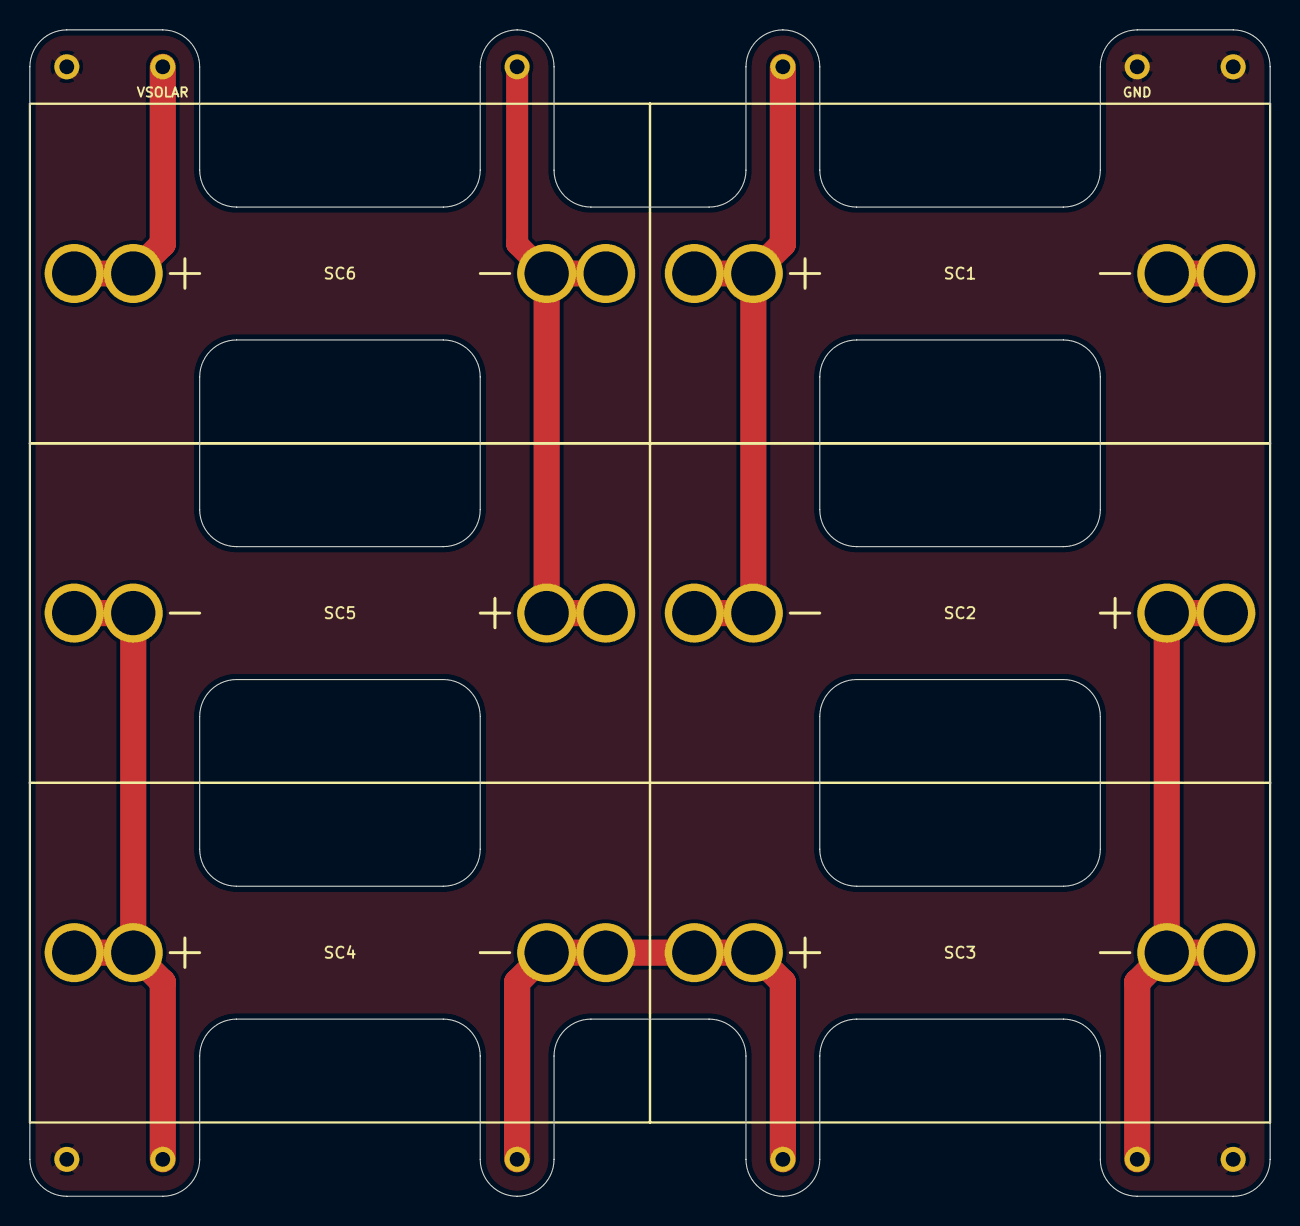
[picture p16: board Cell Backer.kicad_pcb from above]

Board: 2 copper layers, 84.0 x 79.0 mm, 18 parts (0 on the bottom side), 7 nets.
