cmu-argus-2/Avionics-Plus-Z/LightSensorBreakout/LightSensorBreakout.kicad_pcb

## KiCad design LightSensorBreakout/LightSensorBreakout.kicad_pcb (2026-02-09)

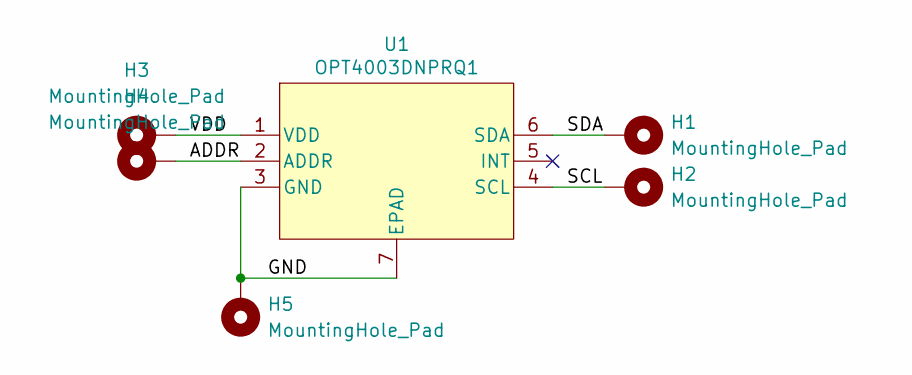
[picture p17: schematic LightSensorBreakout.kicad_sch]

Parts:
H1, H2, H3, H4, H5: MountingHole_Pad; LightSensorPad
U1: OPT4003DNPRQ1; OPT4003

Connections:
/ADDR: H4.1, U1.2 (ADDR)
/GND: H5.1, U1.3 (GND), U1.7 (EPAD)
/SCL: H2.1, U1.4 (SCL)
/SDA: H1.1, U1.6 (SDA)
/VDD: H3.1, U1.1 (VDD)

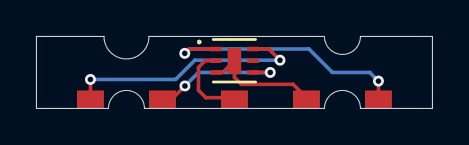
[picture p18: board LightSensorBreakout.kicad_pcb from above]

Board: 2 copper layers, 22.0 x 4.0 mm, 6 parts (0 on the bottom side), 5 nets.
