cmu-argus-2/Avionics-Plus-Z/(commit log)

2025-02-10 Fixed Z+ structure
    [Avionics-SolarPanels.kicad_pcb, Avionics-SolarPanels.kicad_sch, BurnWires.kicad_sch, BusProtection.kicad_sch, ChargeOR.kicad_sch, CoilDriver.kicad_sch, I2CDevices.kicad_sch, I2CProtection.kicad_sch]
2025-02-16 Cleaned up silkscreen
    [CoilDriver.kicad_sch, I2C_Translator.kicad_sch, Interfaces.kicad_sch, LightSensorBreakout.kicad_pcb, LightSensorBreakout.kicad_sch, Mainboard_FPC.kicad_sch, RBF.kicad_sch, USBC.kicad_sch]
2025-02-17 Added BOM
    [Plus_Z.xlsx]
2025-02-28 Added gerbers
    [LightSensorBreakout-B_Cu.gbr, LightSensorBreakout-B_Mask.gbr, LightSensorBreakout-B_Paste.gbr, LightSensorBreakout-B_Silkscreen.gbr, LightSensorBreakout-Edge_Cuts.gbr, LightSensorBreakout-F_Cu.gbr, LightSensorBreakout-F_Mask.gbr, LightSensorBreakout-F_Paste.gbr]
2025-06-17 v3.1 Updates
    [+Z.kicad_pcb, +Z.kicad_sch, ChargeOR.kicad_sch, CoilDriver.kicad_sch, I2CSingleProtection.kicad_sch, I2C_Translator.kicad_sch, Interfaces.kicad_sch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]
2025-06-19 Re-Exported BOM
    [+Z.kicad_pcb, MPPT.kicad_sch]
2026-01-21 Local Stash
    [+Z.kicad_pcb, CoilDriver.kicad_sch, LightSensorBreakout.kicad_pcb, LightSensorBreakout.step, SolarCharger.kicad_sch]
2026-02-09 V4 Updates
    [+Z.kicad_pcb, +Z.kicad_sch, +Z.step, BusProtection.kicad_sch, Cell Backer.kicad_pcb, Cell Backer.kicad_sch, Cell Backer.step, ChargeOR.kicad_sch]
2026-03-23 Coil direction comment clarification
    [+Z.kicad_pcb, +Z.kicad_sch, ChargeOR.kicad_sch, CoilDriver.kicad_sch, I2CSingleProtection.kicad_sch, I2C_Translator.kicad_sch, Interfaces.kicad_sch, MPPT.kicad_sch]
